Matt777777777/Warden/docs/compact_step1.png

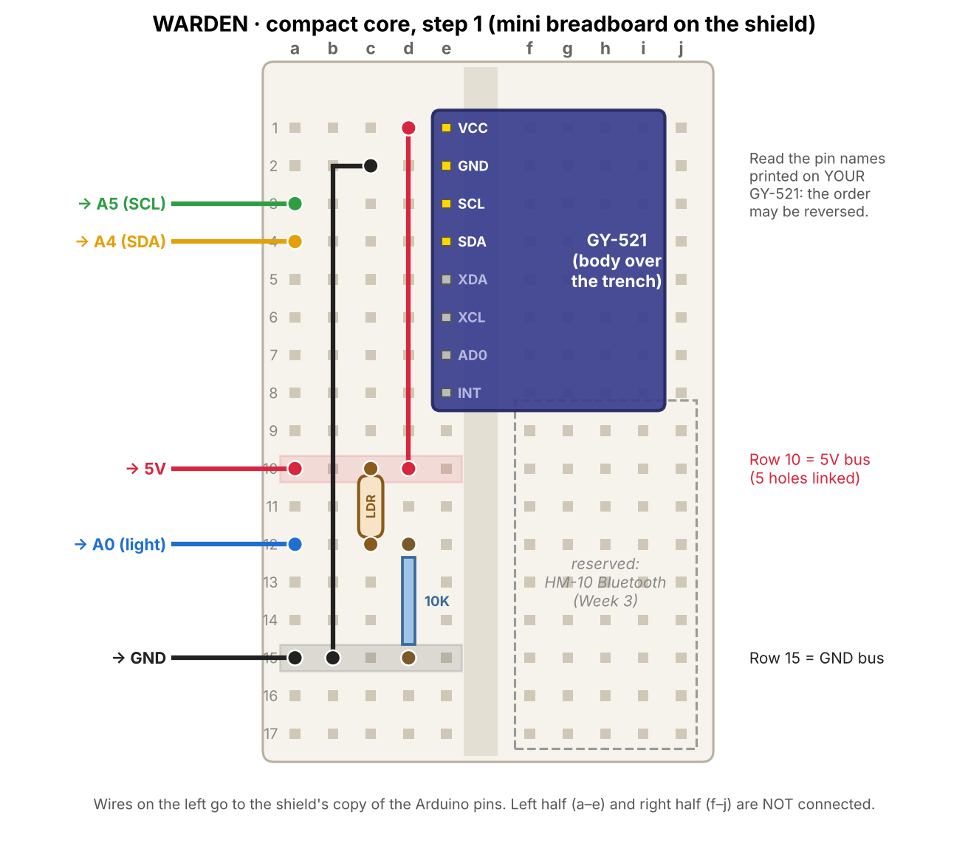
docs/compact_step1.png
