Matt777777777/Warden/docs/media/build-step-2.png

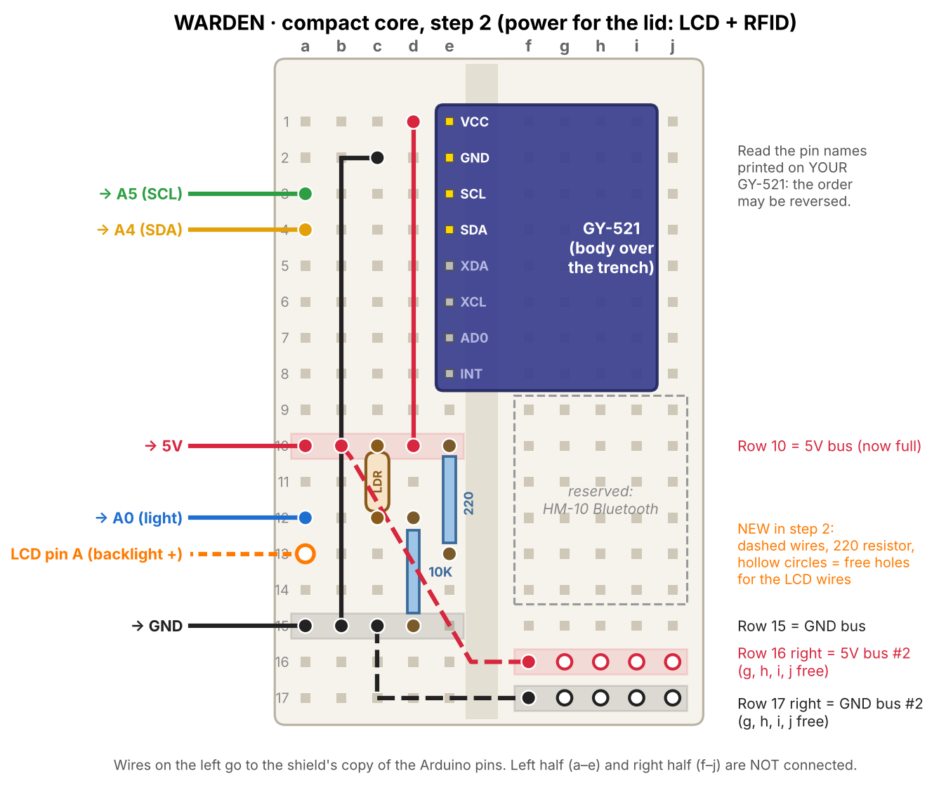
docs/media/build-step-2.png
