Matt777777777/Warden/docs/wiring_week1.png

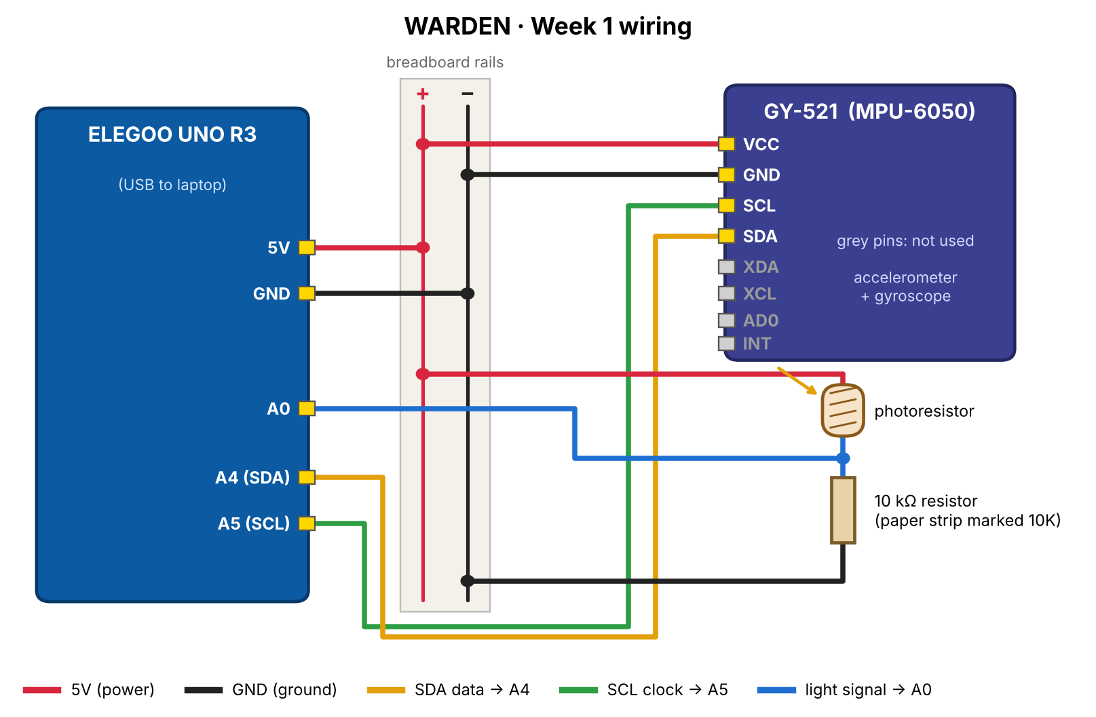
docs/wiring_week1.png
