Matt777777777/Warden/data/test/sessions_log.csv

20261021-100411 | tamper | 1779 | 100.0 | tamper_20261021-100411.csv
20261021-101138 | tamper | 1500 | 100.0 | tamper_20261021-101138.csv
20261021-111651 | tamper | 1499 | 99.9 | tamper_20261021-111651.csv
20261021-111848 | tamper | 1500 | 100.0 | tamper_20261021-111848.csv
20261021-112311 | tamper | 1500 | 100.0 | tamper_20261021-112311.csv
20261021-112456 | tamper | 1500 | 100.0 | tamper_20261021-112456.csv
20261021-113422 | tamper | 1500 | 100.0 | tamper_20261021-113422.csv
20261021-113649 | tamper | 1500 | 100.0 | tamper_20261021-113649.csv
20261021-113842 | tamper | 1421 | 100.0 | tamper_20261021-113842.csv
20261021-114012 | tamper | 1500 | 100.0 | tamper_20261021-114012.csv
20261021-172102 | tamper | 1500 | 100.0 | tamper_20261021-172102.csv
