Matt777777777/Warden/data/test/tamper_20261021-100411.csv

t_ms | ax_g | ay_g | az_g | gx_dps | gy_dps | gz_dps | light | label
2447 | -0.065 | 0.022 | 0.92 | 0.01 | 0.06 | -0.04 | 817 | tamper
2456 | -0.064 | 0.021 | 0.923 | 0.01 | 0.02 | 0.03 | 817 | tamper
2466 | -0.064 | 0.022 | 0.921 | -0.01 | -0.03 | -0.01 | 817 | tamper
2477 | -0.066 | 0.022 | 0.924 | 0.02 | -0.01 | -0.03 | 818 | tamper
2487 | -0.067 | 0.021 | 0.925 | -0.02 | 0.03 | 0.0 | 817 | tamper
2496 | -0.067 | 0.021 | 0.923 | -0.04 | 0.0 | 0.03 | 817 | tamper
2506 | -0.064 | 0.021 | 0.92 | 0.01 | 0.03 | 0.05 | 817 | tamper
2516 | -0.065 | 0.021 | 0.924 | 0.05 | 0.03 | 0.0 | 817 | tamper
2527 | -0.066 | 0.025 | 0.92 | 0.01 | -0.01 | -0.01 | 817 | tamper
2536 | -0.066 | 0.024 | 0.922 | 0.05 | 0.0 | 0.0 | 817 | tamper
2546 | -0.068 | 0.025 | 0.921 | 0.02 | 0.02 | -0.01 | 817 | tamper
2556 | -0.066 | 0.023 | 0.921 | 0.01 | 0.02 | -0.01 | 817 | tamper
2567 | -0.064 | 0.023 | 0.921 | -0.05 | 0.03 | -0.06 | 817 | tamper
2577 | -0.064 | 0.023 | 0.923 | 0.04 | 0.02 | 0.02 | 817 | tamper
2586 | -0.066 | 0.022 | 0.921 | 0.02 | 0.0 | 0.03 | 817 | tamper
2596 | -0.068 | 0.023 | 0.92 | 0.02 | 0.0 | -0.01 | 817 | tamper
2607 | -0.063 | 0.023 | 0.926 | 0.01 | -0.01 | -0.03 | 817 | tamper
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
