Matt777777777/Warden/data/test/tamper_20261021-101138.csv

t_ms | ax_g | ay_g | az_g | gx_dps | gy_dps | gz_dps | light | label
5246 | -0.036 | 0.021 | 0.922 | 0.02 | 0.07 | 0.02 | 807 | tamper
5257 | -0.036 | 0.023 | 0.924 | 0.03 | 0.04 | 0.02 | 807 | tamper
5266 | -0.04 | 0.023 | 0.92 | 0.02 | 0.01 | 0.03 | 807 | tamper
5276 | -0.037 | 0.02 | 0.924 | -0.03 | -0.04 | 0.0 | 807 | tamper
5286 | -0.037 | 0.022 | 0.925 | -0.01 | 0.02 | 0.0 | 807 | tamper
5297 | -0.036 | 0.023 | 0.924 | -0.07 | 0.07 | 0.08 | 807 | tamper
5307 | -0.038 | 0.022 | 0.926 | -0.01 | -0.01 | -0.02 | 807 | tamper
5316 | -0.034 | 0.019 | 0.925 | -0.03 | 0.01 | 0.05 | 807 | tamper
5326 | -0.032 | 0.02 | 0.925 | 0.0 | 0.05 | -0.02 | 807 | tamper
5337 | -0.035 | 0.019 | 0.927 | 0.02 | 0.02 | -0.02 | 807 | tamper
5347 | -0.033 | 0.02 | 0.925 | -0.01 | 0.02 | -0.02 | 807 | tamper
5356 | -0.037 | 0.02 | 0.921 | 0.02 | 0.07 | 0.0 | 807 | tamper
5366 | -0.037 | 0.022 | 0.926 | -0.01 | 0.04 | 0.02 | 807 | tamper
5377 | -0.038 | 0.024 | 0.928 | 0.0 | 0.04 | -0.02 | 807 | tamper
5387 | -0.039 | 0.023 | 0.924 | -0.01 | 0.01 | 0.02 | 807 | tamper
5396 | -0.036 | 0.022 | 0.924 | 0.0 | 0.04 | 0.03 | 807 | tamper
5406 | -0.038 | 0.024 | 0.926 | -0.03 | 0.04 | -0.02 | 807 | tamper
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
