Matt777777777/Warden/data/test/tamper_20261021-111651.csv

t_ms | ax_g | ay_g | az_g | gx_dps | gy_dps | gz_dps | light | label
5236 | 0.065 | -0.007 | 0.924 | 0.03 | -0.06 | 0.02 | 970 | tamper
5246 | 0.066 | -0.006 | 0.921 | 0.0 | 0.0 | 0.04 | 970 | tamper
5257 | 0.068 | -0.005 | 0.923 | -0.03 | -0.03 | 0.06 | 970 | tamper
5266 | 0.068 | -0.006 | 0.919 | -0.03 | -0.01 | 0.01 | 970 | tamper
5276 | 0.068 | -0.006 | 0.923 | 0.0 | 0.0 | 0.02 | 970 | tamper
5286 | 0.071 | -0.005 | 0.918 | 0.05 | -0.04 | -0.02 | 970 | tamper
5297 | 0.068 | -0.007 | 0.921 | 0.02 | -0.09 | -0.04 | 969 | tamper
5307 | 0.069 | -0.006 | 0.92 | -0.01 | -0.09 | 0.06 | 970 | tamper
5316 | 0.069 | -0.006 | 0.921 | 0.02 | -0.06 | 0.01 | 970 | tamper
5326 | 0.067 | -0.004 | 0.917 | 0.02 | -0.03 | -0.02 | 970 | tamper
5337 | 0.068 | -0.008 | 0.92 | 0.08 | -0.01 | -0.02 | 969 | tamper
5347 | 0.065 | -0.006 | 0.917 | 0.03 | 0.03 | -0.01 | 969 | tamper
5356 | 0.066 | -0.006 | 0.921 | -0.01 | -0.03 | -0.01 | 970 | tamper
5366 | 0.065 | -0.007 | 0.921 | 0.0 | -0.06 | -0.04 | 970 | tamper
5377 | 0.066 | -0.005 | 0.92 | -0.03 | -0.03 | -0.02 | 970 | tamper
5387 | 0.067 | -0.006 | 0.92 | 0.02 | 0.02 | 0.04 | 970 | tamper
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
