Matt777777777/Warden/data/test/tamper_20261021-111848.csv

t_ms | ax_g | ay_g | az_g | gx_dps | gy_dps | gz_dps | light | label
5246 | 0.068 | -0.01 | 0.919 | -0.1 | -0.0 | 0.01 | 988 | tamper
5257 | 0.067 | -0.008 | 0.919 | -0.06 | -0.02 | -0.01 | 987 | tamper
5266 | 0.068 | -0.01 | 0.917 | 0.01 | -0.0 | -0.02 | 988 | tamper
5276 | 0.073 | -0.009 | 0.92 | 0.05 | -0.0 | 0.01 | 987 | tamper
5286 | 0.073 | -0.01 | 0.915 | 0.02 | -0.0 | 0.02 | 987 | tamper
5297 | 0.07 | -0.008 | 0.919 | 0.02 | 0.04 | -0.02 | 988 | tamper
5307 | 0.065 | -0.004 | 0.919 | 0.04 | -0.03 | -0.08 | 987 | tamper
5316 | 0.065 | -0.004 | 0.919 | -0.01 | -0.03 | -0.04 | 988 | tamper
5326 | 0.064 | -0.006 | 0.921 | -0.04 | 0.01 | -0.05 | 987 | tamper
5337 | 0.064 | -0.006 | 0.917 | -0.02 | 0.01 | -0.04 | 988 | tamper
5347 | 0.062 | -0.008 | 0.919 | 0.02 | 0.04 | -0.04 | 988 | tamper
5356 | 0.064 | -0.006 | 0.92 | -0.01 | 0.03 | 0.01 | 987 | tamper
5366 | 0.066 | -0.008 | 0.921 | -0.02 | 0.03 | 0.04 | 987 | tamper
5377 | 0.065 | -0.007 | 0.917 | -0.06 | -0.0 | 0.02 | 988 | tamper
5387 | 0.069 | -0.01 | 0.917 | -0.01 | -0.03 | 0.02 | 987 | tamper
5396 | 0.07 | -0.01 | 0.92 | 0.04 | -0.05 | 0.07 | 987 | tamper
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
