Matt777777777/Warden/data/test/tamper_20261021-112311.csv

t_ms | ax_g | ay_g | az_g | gx_dps | gy_dps | gz_dps | light | label
5246 | 0.04 | -0.013 | 0.926 | 0.03 | 0.05 | -0.03 | 1018 | tamper
5257 | 0.042 | -0.009 | 0.917 | 0.02 | 0.06 | -0.01 | 1018 | tamper
5266 | 0.04 | -0.013 | 0.917 | -0.01 | 0.13 | -0.04 | 1017 | tamper
5276 | 0.044 | -0.012 | 0.918 | -0.01 | 0.13 | -0.09 | 1018 | tamper
5286 | 0.043 | -0.014 | 0.922 | 0.02 | 0.13 | -0.11 | 1018 | tamper
5297 | 0.043 | -0.012 | 0.927 | 0.05 | 0.14 | -0.11 | 1018 | tamper
5307 | 0.042 | -0.009 | 0.927 | 0.03 | 0.02 | -0.04 | 1018 | tamper
5316 | 0.042 | -0.007 | 0.918 | -0.01 | -0.04 | -0.04 | 1018 | tamper
5326 | 0.042 | -0.011 | 0.917 | -0.01 | -0.03 | 0.02 | 1018 | tamper
5337 | 0.042 | -0.01 | 0.92 | 0.0 | 0.02 | 0.05 | 1018 | tamper
5347 | 0.039 | -0.012 | 0.919 | 0.02 | 0.05 | 0.05 | 1018 | tamper
5356 | 0.043 | -0.014 | 0.917 | 0.0 | 0.03 | 0.03 | 1018 | tamper
5366 | 0.043 | -0.012 | 0.92 | 0.0 | 0.0 | -0.01 | 1018 | tamper
5377 | 0.041 | -0.012 | 0.922 | 0.0 | -0.01 | 0.03 | 1018 | tamper
5387 | 0.041 | -0.014 | 0.921 | 0.03 | 0.06 | 0.02 | 1018 | tamper
5396 | 0.039 | -0.016 | 0.917 | -0.01 | 0.06 | 0.0 | 1018 | tamper
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
