Matt777777777/Warden/(commit log)

2026-10-20 Add light sensor baseline readings
2026-10-20 Add LCD display test, pin map and Day 1 notes
2026-10-21 Fix countdown samples leaking into recordings, clearer busy-port error
2026-10-21 Mac relay mode for the phone app, firmware v0.3 status line
2026-10-30 On-device AI: dataset (90 sessions), random forest on the UNO, firmware v0.4
    Claude-Session: https://claude.ai/code/session_01HRyDC3vPWY8rqGAbrQhUfs
